plan44/plan44-kicad/plan44.3dmodels/omega2s.FCStd

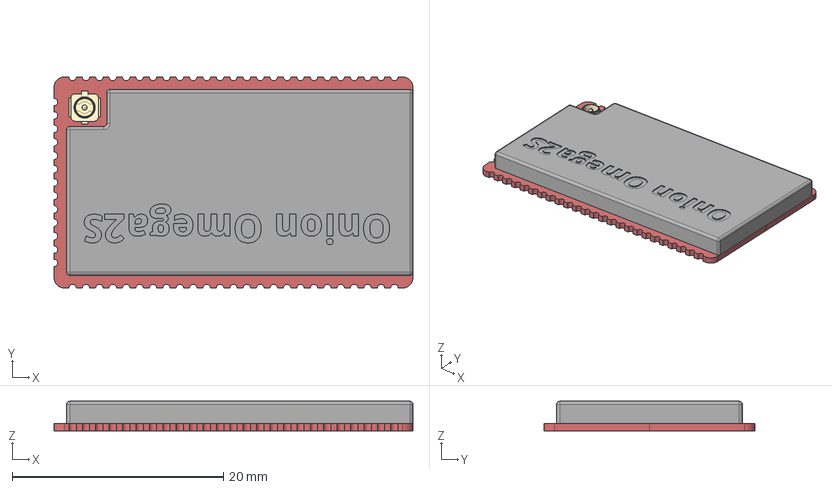
[picture p1: CAD file, 2022-03-25]
plan44.3dmodels/omega2s.FCStd
34.0 x 20.0 x 2.80 mm
conn_rf_uFL_3450020P1
