plan44/plan44-kicad/(commit log)

2017-06-11 Initial commit - collected all footprints from different projects here
2017-06-11 unified footprint names, all with "plan44:" prefix
2017-06-11 Template PCB for Hammond 1591XXB case
    [For Hammond 1591XXB.kicad_pcb]
2017-06-11 Renamed footprints according to conventions
2017-06-13 Some footprint name adjustments
2017-06-16 Omega2S: added heatsink pads
2017-06-16 Added DB9 male and USB Micro footprints
2017-07-21 Added footprint for CRM2512 shunt
2017-07-21 Omega2S: fixed mask for heat spreader, was on the wrong side of the board
2017-11-04 Added RAK831 footprint (2x12 header + outline + mounting holes)
2018-07-10 Adjusted Stelvio 2P and 5P footprints to have pin 1 in origin, no project specific refs and names any more
2018-07-10 Fixed Stelvio 3P footprint name
2018-07-10 Added straight (-S) versions of the stelvio connectors (2P and 3P so far)
2018-07-10 simple huge SMT pads for soldering power wires
2018-07-10 Added straight (-S) version of the stelvio 4P connector
2018-07-31 The "Stelvio" connectors need 1.3mm holes, 1.2mm was too close to manufacturing tolerances of PCBs (some OSHPark PCBs were ok, some too tight)
2018-08-19 Stelvio footprints: THT must not have paste mask layer!
2018-08-19 CONFIG-PAD-2P: no paste mask layer, because these are meant to be soldered manually and the gap between pads is so narrow that pasted solder might close the contact when exposed
2020-03-26 Some more footprints
2020-03-26 More PCB templates for Hammond 1591XX case, extended with more room + p44 shield
    [For Hammond 1591XXB extended.kicad_pcb, For Hammond 1591XXB p44-expansion.kicad_pcb]
2020-03-26 Templates for Hammond 1591XXB redrawn, higher precision
    [For Hammond 1591XXB extended.kicad_pcb, For Hammond 1591XXB p44-expansion.kicad_pcb, For Hammond 1591XXB.kicad_pcb]
2020-03-26 Symbols: add P44 expansion connector (similar, but not fully equal to, Rpi-Expansion)
2020-04-26 symbol for extra 2 pins on P44-expansion connector (2x13 hard to get, 2x14 more common)
2021-04-27 pp4-expansion: add minimized version of expansion header when pcb is mainboard
    [For Hammond 1591XXB p44-expansion.kicad_pcb]
2021-04-27 Connector pins should be "passive"
2022-01-25 KiCad 6.0: add auto-migrated .kicad_sym
2022-02-02 Precise template for Hammond 1591XXA enclosing
    PCB outline exactly according to "max PCB size" specs in Hammond datasheet
    [For Hammond 1591XXA extended.kicad_pcb]
2022-03-25 Add 2.4GHz WiFi PCB Antenna
2022-03-25 Add WS281x PCB connector footprints
2022-03-25 Omega2S: enhanced geometry to work better for heating plate soldering as well as manual soldering, added 3D model (GPLv3 licensed file, see omega2s.wrl_LICENSE.md)
    [omega2s.FCStd]
2022-03-25 Add Omega2S Flexipin footprint version ("socket" pins for solder-free contacting of castellated modules like Omega2S)
    See https://github.com/solderparty/flexypin for info about FlexiPin)
2023-10-09 updated configpad footprint - common square solder mask including both pads
    This is in response to Seeed feedback, because the solder dam would be too thin when these are two separate pads.
2024-01-24 OPA171: fix pin numbering: we have the SOT23 (DVB) variant, which has different pin numbers
    - we were using numbering from OPA171-DRL, which is in the much smaller SOT-553 package that is barely solderable manually
2024-03-01 Omega2 TH: pads must not have silkscreen or paste layers!
    probably this was a left-over from medieval eagle import tool looooong ago
2024-03-01 New parts: SMT button "SW_PTS645SM95SMTR92LFS" and 5pin stepper motor connector "S5B-ZR-SM4A-TF_JST"
2024-04-14 WiFi-PCB-Antenna: try to make more DRC compliant (not really successfully), remove silk screen lines
2024-07-05 CONFIG-PAD default font size changed, default to appear in BOM
